lukaslehnert/DigitalAnalog/README.md

This is the code and PCB for the Digital Analog project.

View the [build log](http://ryan.krabath.net/blog/category/watch/) for more information.
