lukaslehnert/DigitalAnalog/(commit log)

2012-03-12 First commit of the watch project.
    Makefile is heavily cribbed from Paul Grayson: http://paul.graysonfamily.org/thoughts/avrlinux/
    watch.c is from him as well, but it'll be blown away soon enough.
    [watch.c]
2012-03-12 Moved some things around and made the LED blink.... SUCCESS!
2012-03-12 Added a comment to explain the current sinking nature of the setup.
2012-03-13 Initial commit of Wire library. Let the Frankenstining begin!
2012-03-13 I got rid of the Arduino two wire shit and have "ported" a two wire interface for the Tiny85 to the tiny24.
    By "ported" I mean I changed the name of the processor so that the #define works.
    I haven't tested it. I'm that awesome.
    There's probably a bunch of extra stuff in here now.
2012-03-13 Trying to cut the program size way down!
2012-03-13 Assembler implementation of i2c master, courtesy of Peter Fleury.
    http://homepage.hispeed.ch/peterfleury/avr-software.html
    http://homepage.hispeed.ch/peterfleury/group__pfleury__ic2master.html
2012-03-13 Going right to the source for i2c master now. They claim it's just a few hundred bytes. We'll see.
    http://www.atmel.com/Images/doc2561.pdf
2012-03-14 Another BS wire library
2012-03-14 I've picked a I2C library and got it mostly working. Cleaning up the cruft.
2012-03-15 Beginning to debug the I2C bus.
    Fun stuff.
2012-03-17 A bunch of changes here to try to get it to work. We're getting a different error now... 0x01
    Something about an address being out of range. I'll figure it out some other time.
    [watch.c]
2012-03-20 Blew away the Atmel i2c implementation in favor of the ASM version I found earlier. Might work better.
2012-03-20 Integrated the ASM I2C implementaion into the project. Compiles, but isn't tested.
2012-03-20 Refactored LED code into it's own set of files.
    Began implementation of the RTC library.
    This compiles but isn't tested.
2012-03-21 Further work on the RTC library.
    Reading the RTC works, writing to the RTC works, but re-writting fails. Still working on that.
    [LEDstatus.c, RTC.c, RTC.h, watch.c]
2012-03-21 Some code cleanup
    And a few small features (error checking, mostly)
    And fewer compiler warnings.
    [LEDstatus.c, RTC.c, RTC.h, watch.c]
2012-03-23 This is the shifter code. It compiles but it's not tested.
    I've integrated it with watch.c to make it easier to troubleshoot the RTC/I2C problems.
    [shift.c, shift.h, watch.c]
2012-03-23 Fixes for the shift library. It's working!
    [shift.c, shift.h, watch.c]
2012-03-24 Storing data to RTC works!
    Full changeset:
    Added LEDoff() function to complement LEDon()
    Cleaned up RTC_UpdateTime() substantially (and now it works)
    minimized the timing delay in SR_tick() with a creative addition
    cleaned up the main loop to display output very cleanly
2012-03-24 Minor cleanup
    Moved a variable defination from the .h into the .c. This prevents compile time error messages.
    [shift.c, shift.h]
2012-03-27 I2C errors are now recovered from gracefully.
    It used to flash the LED eternally, but now it just tries again.
    [RTC.c]
2012-03-27 Interrupts working!
    But they're not yet abstracted. That comes next.
2012-03-27 Various small improvements.
    Removed some unnecessary defines, changed the output to be closer to the form that we'll need for the watch face, made changes to RTC.[c,h] that I swear I've made before.
    Interrupts are still working!
2012-03-28 Moved the interrupt code
    into its own set of files.
2012-03-28 Output now works almost exactly like it will on the watch face.
    Also reverted the whole "moved interrupt code into it's own file" thing. It didn't work.
    [watch.c]
2012-04-04 Improved the interrupt handler, plus other tweaks.
    Other tweaks:
    Revamped the housekeeping loop
    cleaned up comments a bit
2012-04-04 Playing around with some power savings
2012-04-13 This is version 2 of the pcb.
    Version 1 only exists as gerbers at this point, which is fine becuase version 1 doesn't work.
    [watch.brd, watch.sch]
2012-04-13 Further PCB revisions.
    [watch.brd, watch.sch]
2012-04-13 One last routing change.
    [watch.brd]
2012-04-17 This is Rev2 of the board.
    Just sent to the fab house.
    [watch.brd, watch.sch]
2012-05-11 Beginning of the implementation of the actual device.
    These changes make the status light on the watch face blink.
2012-05-12 PCB bug fix.
    A trace on the board wasn't routed. The watch wouldn't update without it.
    [watch.brd, watch.sch]
2012-05-15 Working watch face.
    Note that I've only tested the minutes display. I still have some soldering to do to test the hour display.
2012-05-17 Minor cleanup / code stability
    [RTC.h, shift.c]
2012-05-17 I'm still working out the interface issues.
    The minute hand will now increment, but I'm still having major issues with the code stability. Or maybe it's the PCB. Or maybe a bad component.
    This is getting complicated...
    [face.c, face.h, watch.c]
2012-05-17 Minor PCB change
    I straightened a single trace. It was bothering me.
    [watch.brd]
2012-05-18 Great success!
    Abstracted the SR functions a bit.
    Solidified the display code. The fancy spinning bit now transitions into the time display. Now I just need to spruce up the WF_clear() function a bit.
    It looks like the instability issues I was having were mainly due to a faulty shift register. Debugging hardware sucks.
    [face.c, shift.c, shift.h, watch.c]
2012-05-22 Added some component values to the schematic.
    [watch.brd, watch.sch]
2012-05-22 This watch is displaying the time!
    Changes:
    Removed some unnecessary code
    Some refactorization
    Major revamp of the main loop.
    Issues:
    Interrupts not working. May be due to a hardware bug.
    [RTC.c, face.c, face.h, watch.c]
2012-05-22 Dealing with corner cases.
    Now the hour displays correctly during the midnight hour.
    [face.c]
2012-05-23 Updated Schematic
    Fixed some labels.
    Further work is needed on the 1Hz LED. It doesn't work as specified.
    [watch.brd, watch.sch]
2012-05-23 Massive changes
    Total overhaul of the implementation.
    Interrupts working.
    Time is not being stored across a loss of power.
    The logic around the "top of the hour" is flawed and needs to be reconsidered.
    The case statement in the interrupt handler could potenitally benefit from covering a few more cases.
2012-05-24 Updated Schematic
    Reversed the polarity of the 1Hz LED. Thanks to Mike for pointing out the easy fix.
    Also improved the grounding of various components.
    [watch.brd, watch.sch]
2012-05-29 Removed the old probe points and shift registers.
    [watch.brd, watch.sch]
2012-05-29 Placed the new shift registers
    TODO:
    Still a lot of routing to do.
    Implement new switches
    fix layout of non-location-sensitive parts
    [watch.brd, watch.sch]
2012-05-29 Small change to RTC_init
    This change should allow us to preserve the time across power downs.
2012-06-01 Further PCB changes
    [watch.brd, watch.sch]
2012-06-01 Revamped interrupt handler
    re-written interrupt handler to allow for a "press and hold" mechanism
2012-06-01 Potential fix for displaying times after midnight.
    [face.c]
2012-06-05 PM is now handled correctly.
    The RTC sets a bit to show that it's PM. The mask I was using to read
    the RTC was returning that bit as part of the integer, which was wrong.
    [RTC.c]
2012-06-17 Further work on rev3
    [watch.brd, watch.sch]
2012-08-03 Cleaned up the schematic a bit for printing.
    [watch.sch]
2012-09-15 Working on the PCB.
    [watch.brd, watch.sch]
2012-09-22 Moved the display onto a daughter board.
    consider moving the resister that determines intensity onto the daughter board.
    [watch.brd, watch.sch]
2012-09-27 Finished watch face layout
    One battery module finished.
    [watch.brd, watch.sch]
2012-09-28 Finished battery layout.
    Finished physical layout (dimensions, shapes)
    [watch.brd, watch.sch]
2012-10-02 More board updates
    [watch.brd]
2012-10-02 Starting to work on the panelization.
    [gerbmerge.cfg]
2012-10-02 Split out the battery module
    [battery.brd, battery.sch]
2012-10-02 Clean up after eagle touches the battery module
2012-10-11 Many many changes to the layout. Highlights:
    Added diodes to prevent the batteries from charging each other
    Added an off switch to isolate the batteries.
    Fixed the size of the battery. It's larger than it was supposed to be.
    Bottom battery module ports are now available.
    Switched to a surface mount crystal
    Switched to contact-only programming headers. Pitch is the same, but it's only SMD now.
    Opened up some space for the larger microprocessor.
    [watch.brd, watch.sch]
2012-10-15 Connected both ends of the status LED to the microprocessor. We're going to use it as a light detector!
    [watch.brd, watch.sch]
2012-10-17 Changed diodes
    [watch.brd, watch.sch]
2012-10-17 More small tweaks. Part exchanges, some layout fixes, etc.
    [watch.brd, watch.sch]
2012-11-15 Board is getting to be complete!
    [watch.brd, watch.sch]
2012-11-19 Begin to split out design into seperate boards.
    [face.brd, face.sch, main.brd, main.sch, watch.brd, watch.sch]
2012-11-19 Trimmed out unrelated sections.
    (This concludes the "poor-man's" eagle file split)
    [battery.brd, battery.sch, face.brd, face.sch, main.brd, main.sch]
2012-11-20 Fixed some missing pads and traces.
    [main.brd, main.sch]
2012-11-20 Small tweaks to the boards
    [battery.brd, face.brd, face.sch, main.brd, main.sch]
2012-11-20 Updated part documentation.
    [main.brd, main.sch]
2012-11-21 Board modifications
    Changed headers
    updated some part values
    [face.brd, face.sch, main.brd, main.sch]
2012-11-22 Added the mounting holes for the strap bracket.
    [battery.brd, main.brd]
2012-11-22 Updated some part defs.
    Specifically, some pad shapes/sizes were updated and some silkscreens were changed around.
    [battery.brd, battery.sch, face.brd, face.sch, main.brd, main.sch]
2012-11-25 Flipped pins PA1 and PB2 to put OE on a hardware PWM pin.
    Other small improvements.
    [main.brd, main.sch]
2012-11-25 Moved a trace to a more pleasing position.
    [main.brd]
2012-11-26 Moved the boost converter IC away from the shift register.
    Beefed up the VRAWSWITCHED traces
    Other minor trace changes.
    [main.brd, main.sch]
2012-11-26 Dealing with the PCB section cluter.
2012-11-26 Minor routing changes
    [face.brd]
2012-11-27 Gerber file handling tools.
    [gerbmerge.cfg]
2012-11-27 Gerber merging tweaks.
    [gerbmerge.cfg]
2012-11-28 A potential new battery module layout.
    [battery.brd, battery.sch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]
2012-11-29 Another iteration of the battery module
    [battery.brd, gerbmerge.cfg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]
2012-11-30 Adding values to parts, further tweaks to makefile
    [main.brd, main.sch]
2012-11-30 Partlists for manufacturing
    [Partlist.csv]
2012-12-04 Mostly complete partlist
    [Partlist.csv]
2012-12-05 Switched out a pull-up resistor for a debouncing capacitor
    [main.brd, main.sch]
2012-12-05 Finished partlist, deleted extra files.
    [Partlist.csv]
2012-12-06 My csv didn't have csvs.
    [Partlist.csv]
2013-01-17 This is what got sent to the fab.
    It turns out there's some extra space under the battery holder, so we'll hide some things under there!
    [battery.brd, battery.sch, gerbmerge.cfg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]
2013-01-17 Non-working LED sensor module.
    Putting on the back burner until I can get the shift register working to give me a readout.
2013-01-20 Working LED light sensor!
2013-01-21 Code cleanup, round 1
    Moved the new display functions into the shift register "class".
    Utilize a 5 sample average - may reduce flicker.
    Moved some pin assignments into pindefs.h
    Cleaned up comments, attributed source.
2013-02-03 Library-ized.
    This is the working implementation of the LEDsensor "library"
2013-02-21 We're flashing the status LED
2013-02-24 Added LEDsensor to the dependent files.
2013-02-24 Added enable(), disable(), bargraph() and displayData()
    enable also sets up PWM dimming of the LEDs based on data from LEDsensor.
    Cleaned up the code for the other functions and removed some old device specific workarounds.
    [face.c, face.h]
2013-03-02 Working watch buttons.
